mongonta0716/stack-chan/case/contributed/mongonta_case_for_SG90_and_M5GoBottomBoard/case_for_SG90andM5GoBottomBoard/alpha_metal_case/stackchan_bracket_metal.stl

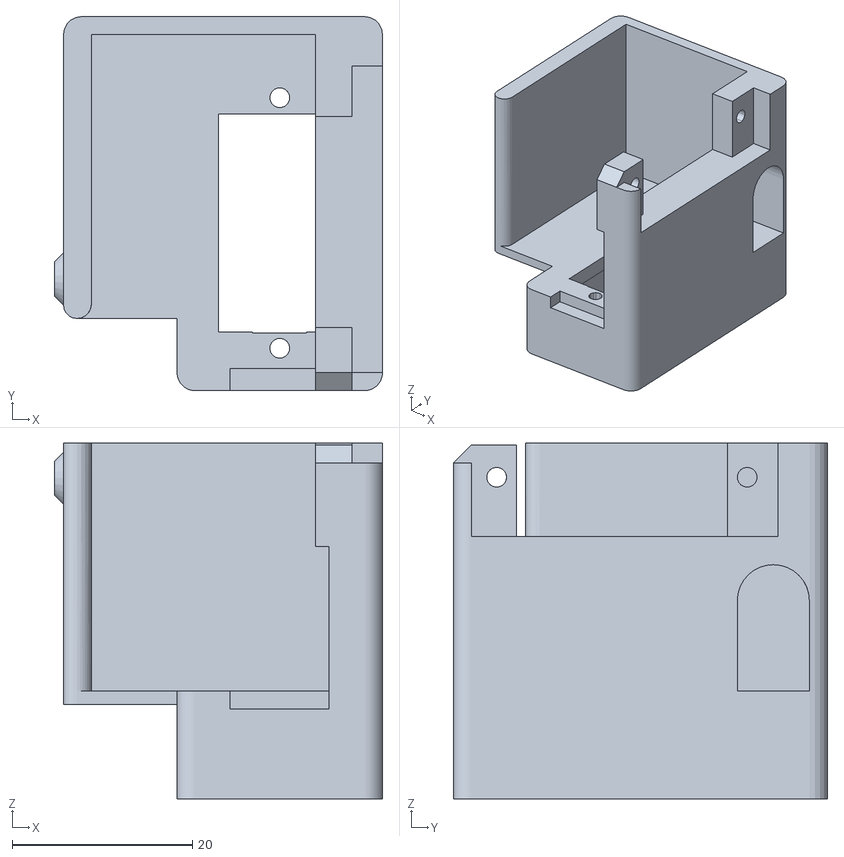
[picture p1: CAD file, 2022-09-23]
case/contributed/mongonta_case_for_SG90_and_M5GoBottomBoard/case_for_SG90andM5GoBottomBoard/alpha_metal_case/stackchan_bracket_metal.stl
36.4 x 41.5 x 39.5
