mongonta0716/stack-chan/case/contributed/mongonta_case_for_SG90_and_M5GoBottomBoard/case_for_SG90andM5GoBottomBoard/For_JLCPCB_Translucent_regin_model/feet_SG90_v1.0.stl

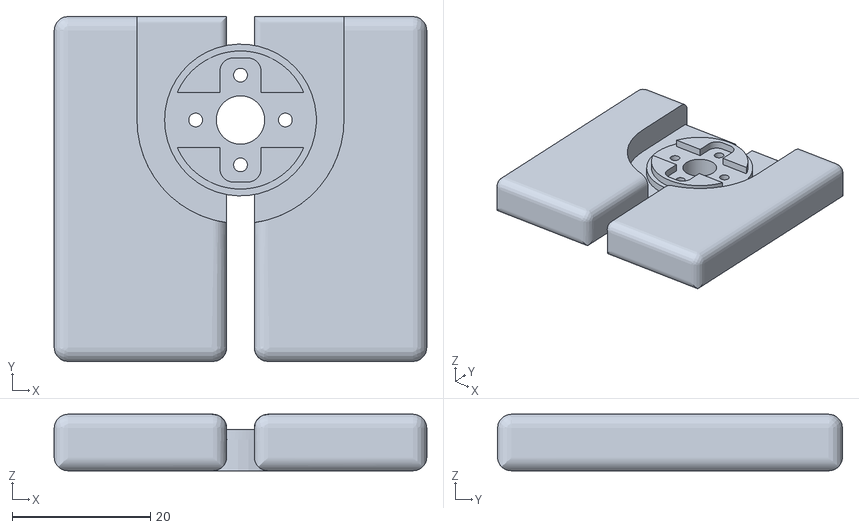
[picture p2: CAD file, 2023-07-15]
case/contributed/mongonta_case_for_SG90_and_M5GoBottomBoard/case_for_SG90andM5GoBottomBoard/For_JLCPCB_Translucent_regin_model/feet_SG90_v1.0.stl
54.0 x 50.0 x 8.20
