mongonta0716/stack-chan/case/contributed/mongonta_case_for_SG90_and_M5GoBottomBoard/case_for_SG90andM5GoBottomBoard/For_JLCPCB_Translucent_regin_model/hat_cat_ear_v2.0.stl

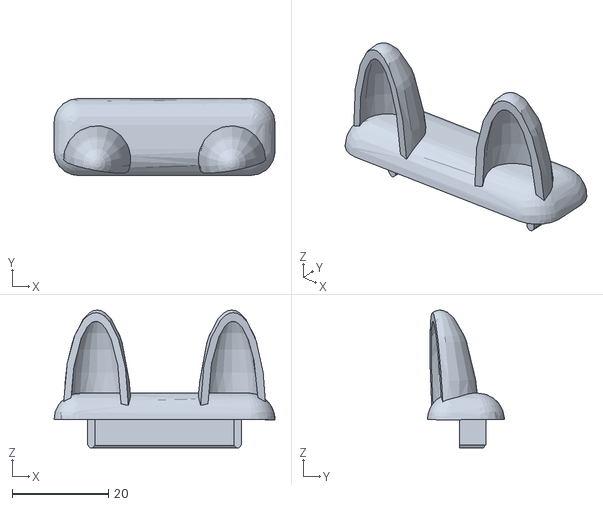
[picture p3: CAD file, 2023-07-15]
case/contributed/mongonta_case_for_SG90_and_M5GoBottomBoard/case_for_SG90andM5GoBottomBoard/For_JLCPCB_Translucent_regin_model/hat_cat_ear_v2.0.stl
46.0 x 16.0 x 28.7
