mongonta0716/stack-chan/case/contributed/mongonta_case_for_SG90_and_M5GoBottomBoard/case_for_SG90andM5GoBottomBoard/alpha_metal_case/stackchan_shell_metal.2.stl

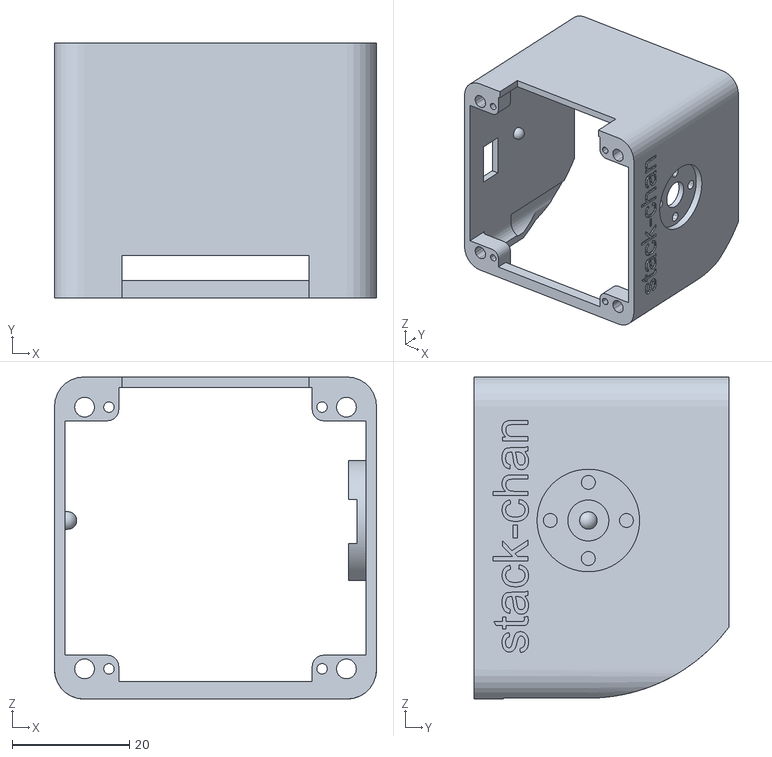
[picture p4: CAD file, 2022-09-23]
case/contributed/mongonta_case_for_SG90_and_M5GoBottomBoard/case_for_SG90andM5GoBottomBoard/alpha_metal_case/stackchan_shell_metal.2.stl
55.0 x 43.5 x 55.0
