mongonta0716/stack-chan/case/contributed/mongonta_case_for_SG90_and_M5GoBottomBoard/case_for_SG90andM5GoBottomBoard/alpha_metal_case/stackchan_shell_metal.stl

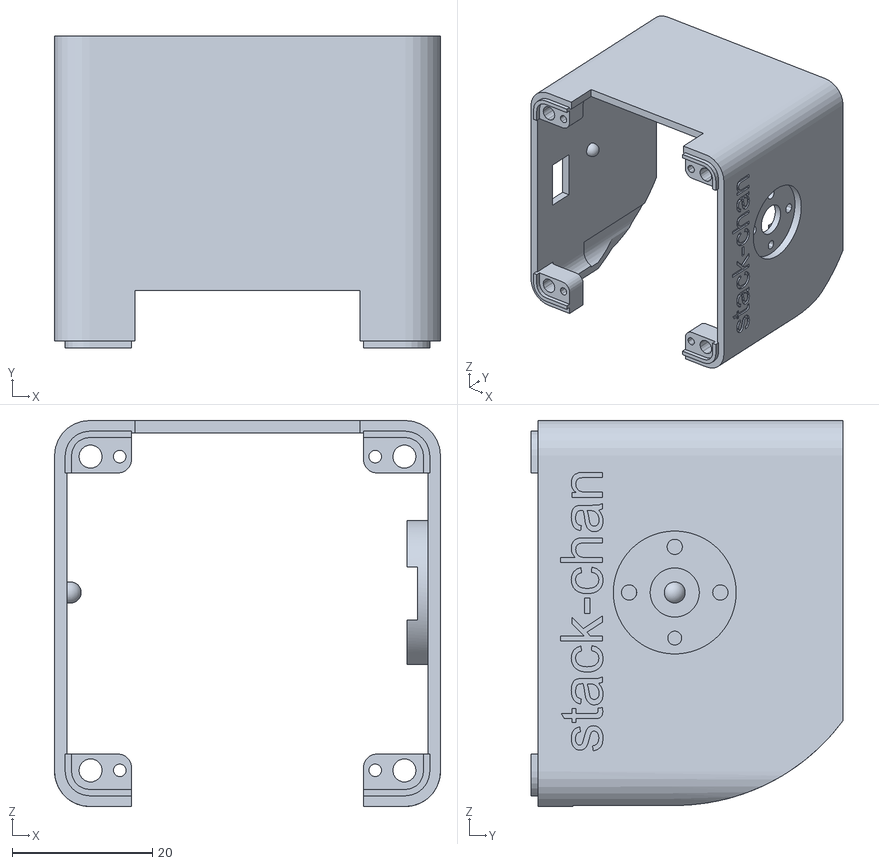
[picture p5: CAD file, 2022-09-23]
case/contributed/mongonta_case_for_SG90_and_M5GoBottomBoard/case_for_SG90andM5GoBottomBoard/alpha_metal_case/stackchan_shell_metal.stl
55.0 x 44.5 x 55.0
