mongonta0716/stack-chan/(list of files, cad)

Other CAD files:
case/contributed/mongonta_case_for_SG90_and_M5GoBottomBoard/case_for_SG90andM5GoBottomBoard/alpha_metal_case/feet_SG90_metal.stl
case/contributed/mongonta_case_for_SG90_and_M5GoBottomBoard/case_for_SG90andM5GoBottomBoard/For_JLCPCB_Translucent_regin_model/bracket_SG90_v2.0.stl
case/contributed/mongonta_case_for_SG90_and_M5GoBottomBoard/case_for_SG90andM5GoBottomBoard/For_JLCPCB_Translucent_regin_model/shell_for_translucent_v1.0.stl
