mongonta0716/stack-chan/(commit log)

2022-09-23 add alpha_metal_parts
    [feet_SG90_metal.stl, stackchan_shell_metal.2.stl, stackchan_shell_metal.stl]
2023-07-15 Add for JLCPCB Translucent resin model of Takao Version
    [bracket_SG90_v2.0.stl, feet_SG90_v1.0.stl, hat_cat_ear_v2.0.stl, shell_for_translucent_v1.0.stl]
